AdamV3D/RR-V-Minion-Mods/2kg or Larger Spool Holder/2KG or larger spool holder 100mm wide spool.png

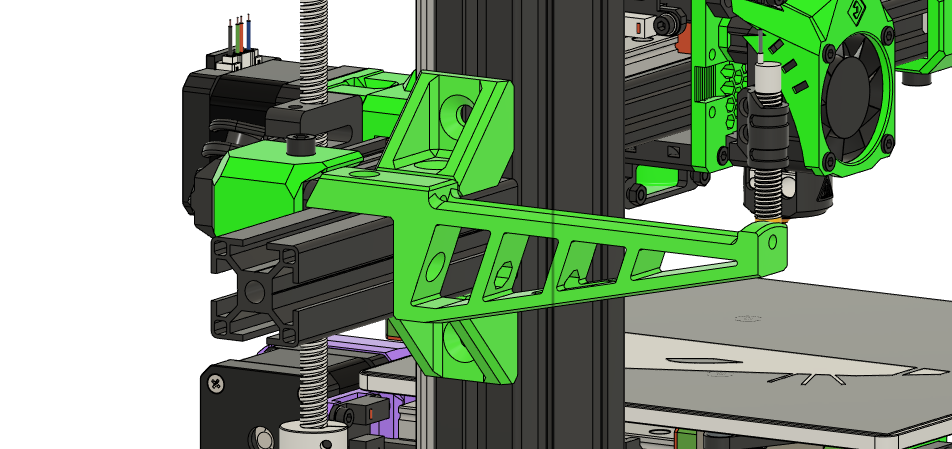
2kg or Larger Spool Holder/2KG or larger spool holder 100mm wide spool.png
