AdamV3D/RR-V-Minion-Mods/2kg or Larger Spool Holder/Large Spool Holder (2).jpg

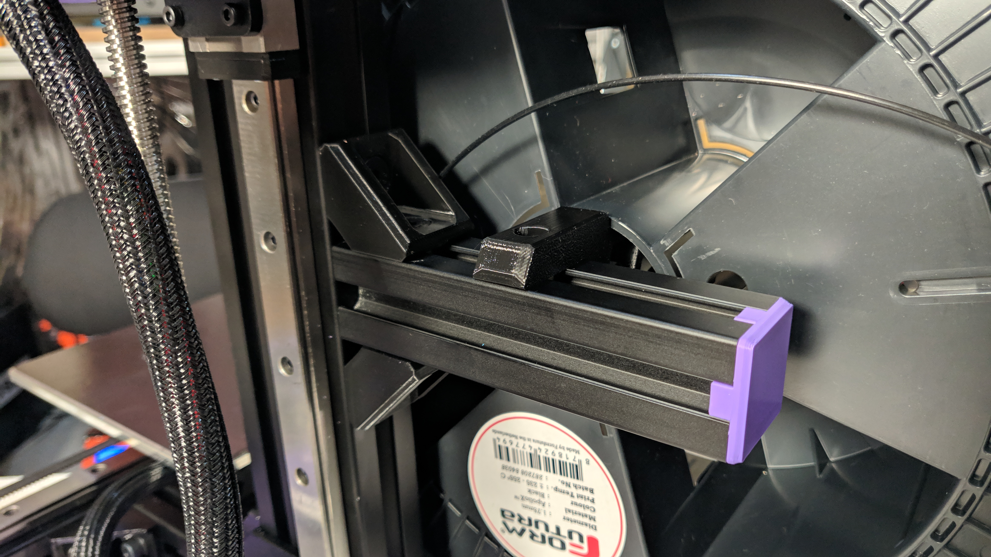
2kg or Larger Spool Holder/Large Spool Holder (2).jpg
