AdamV3D/RR-V-Minion-Mods/Single Piece Spool Holder/spool holder alone.png

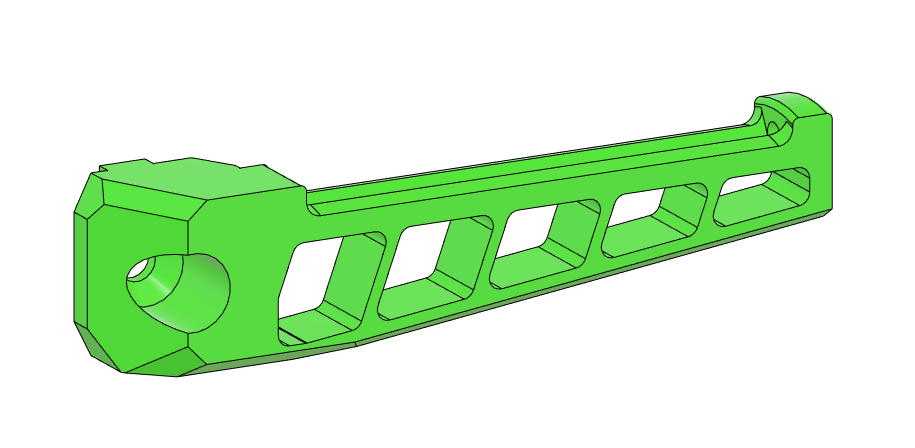
Single Piece Spool Holder/spool holder alone.png
