AdamV3D/RR-V-Minion-Mods/Single Piece Spool Holder/Spool Holder Mounted.png

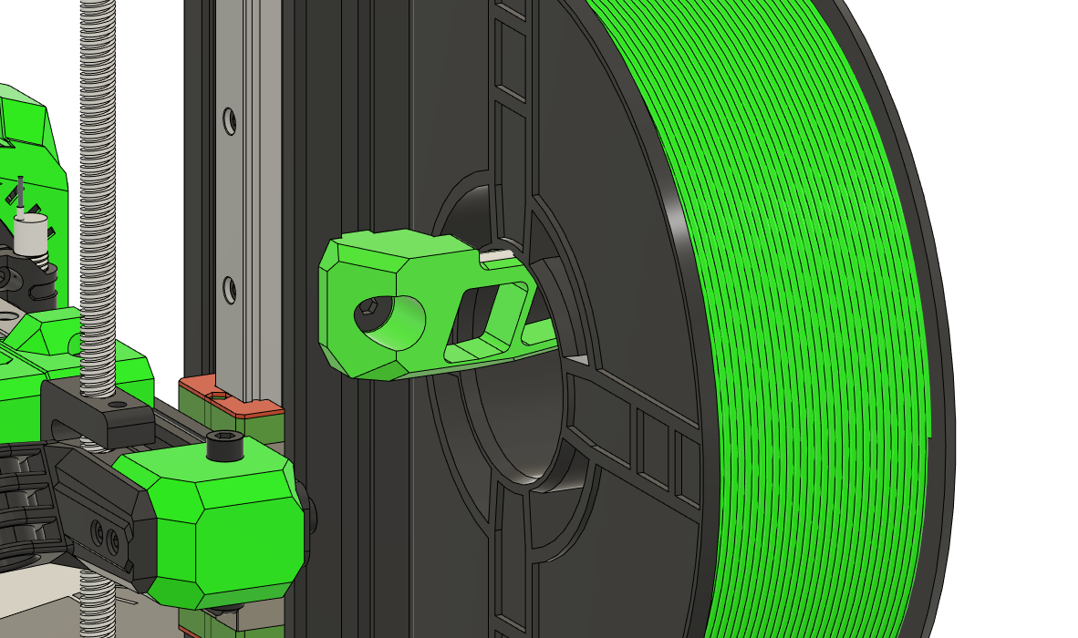
Single Piece Spool Holder/Spool Holder Mounted.png
