AdamV3D/RR-V-Minion-Mods/Single Piece Spool Holder/spool holder with PTFE tube.png

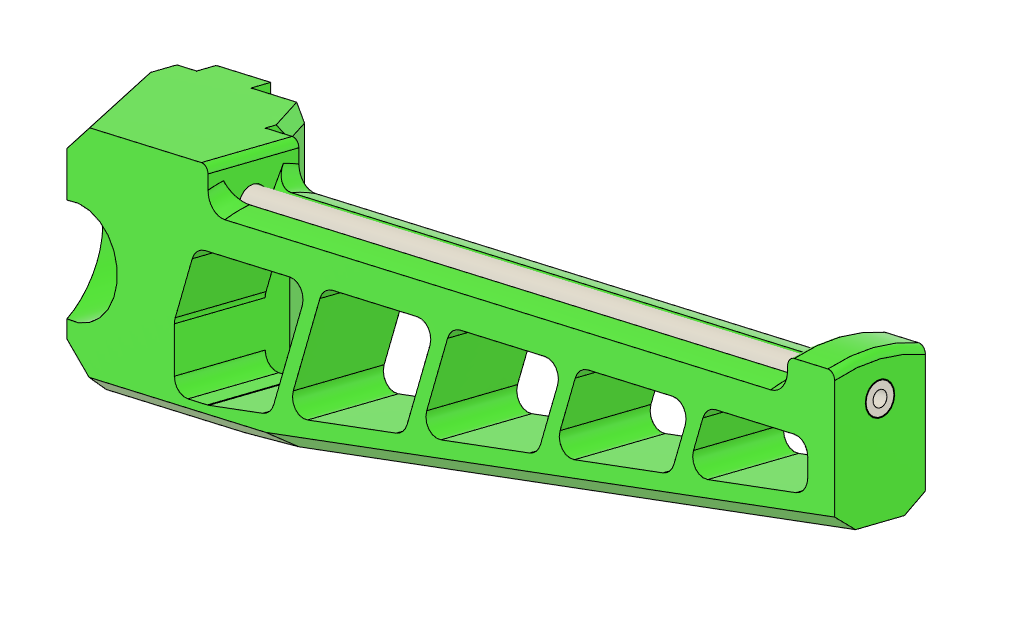
Single Piece Spool Holder/spool holder with PTFE tube.png
