AdamV3D/RR-V-Minion-Mods/Z Top with Stop And Feed tube/Z Cap with Feed Tube (1).jpg

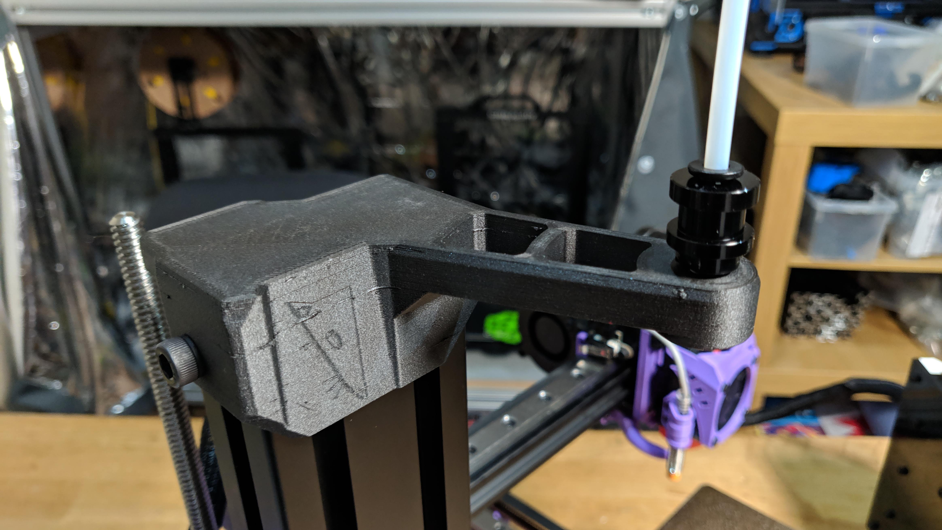
Z Top with Stop And Feed tube/Z Cap with Feed Tube (1).jpg
