AdamV3D/RR-V-Minion-Mods/Z Top with Stop And Feed tube/Z Cap with Feed Tube (3).jpg

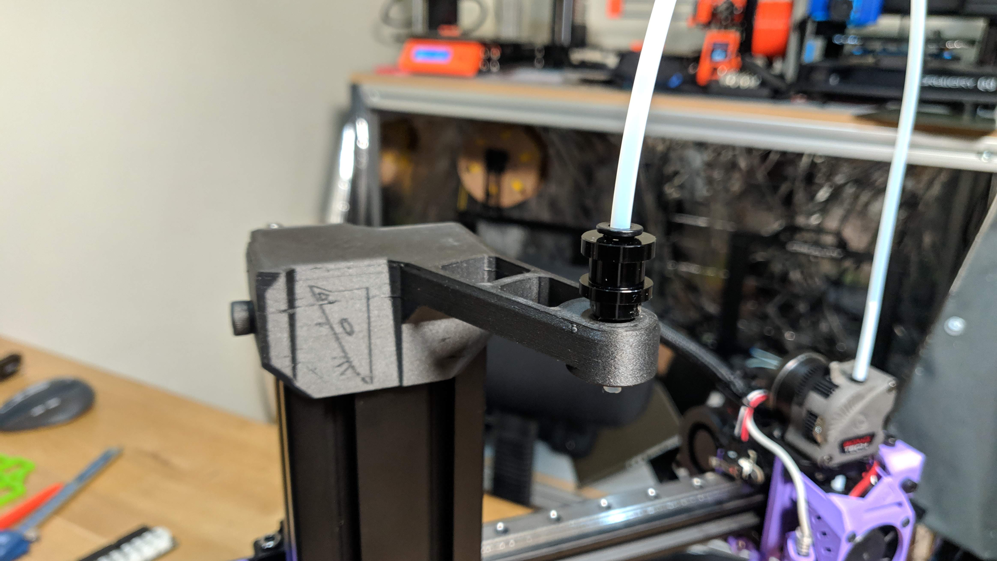
Z Top with Stop And Feed tube/Z Cap with Feed Tube (3).jpg
