AdamV3D/RR-V-Minion-Mods/2kg or Larger Spool Holder/Single Piece 2KG Spool Holder v16.stl

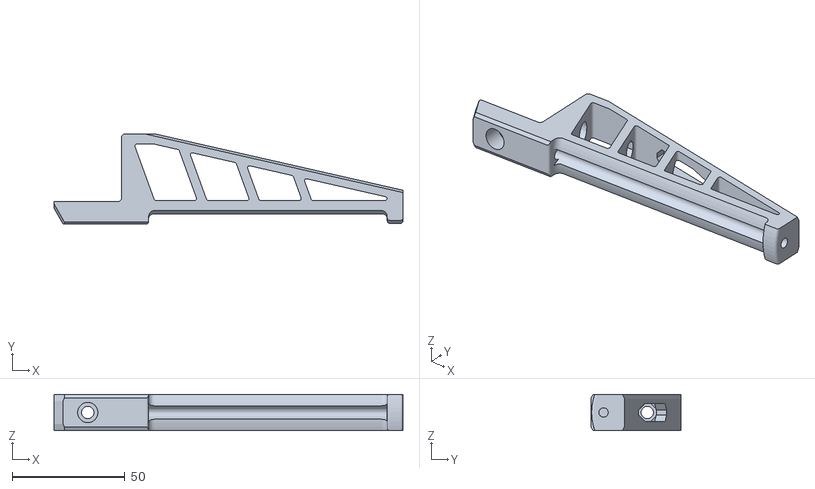
[picture p12: CAD file, 2022-04-16]
2kg or Larger Spool Holder/Single Piece 2KG Spool Holder v16.stl
155.0 x 40.0 x 16.0
