AdamV3D/RR-V-Minion-Mods/ABS Optimised and Orientated Parts/STL/x_motor_cage v8(eva3).stl

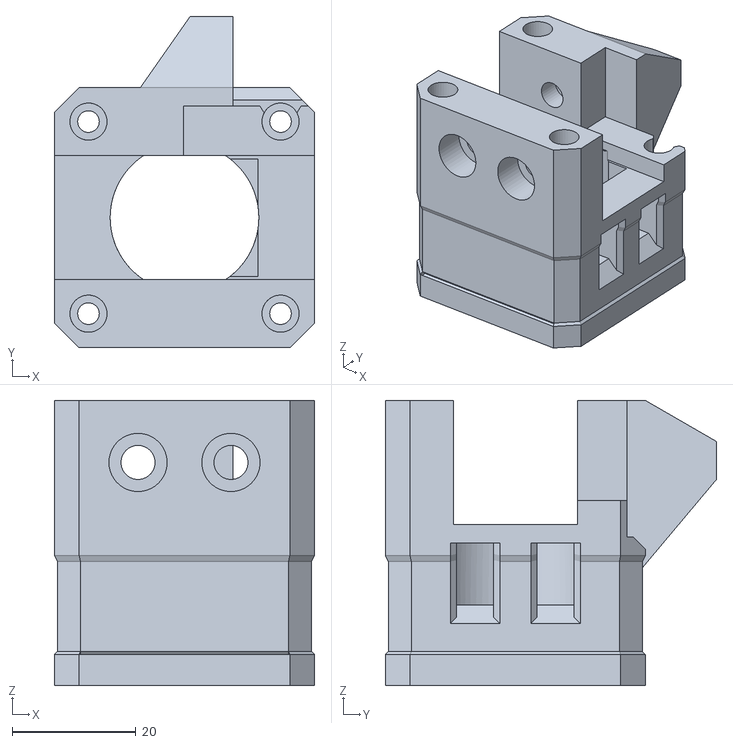
[picture p13: CAD file, 2022-08-25]
ABS Optimised and Orientated Parts/STL/x_motor_cage v8(eva3).stl
42.0 x 53.5 x 46.0
