AdamV3D/RR-V-Minion-Mods/Single Piece Spool Holder/Single Piece Spool Holder v28.stl

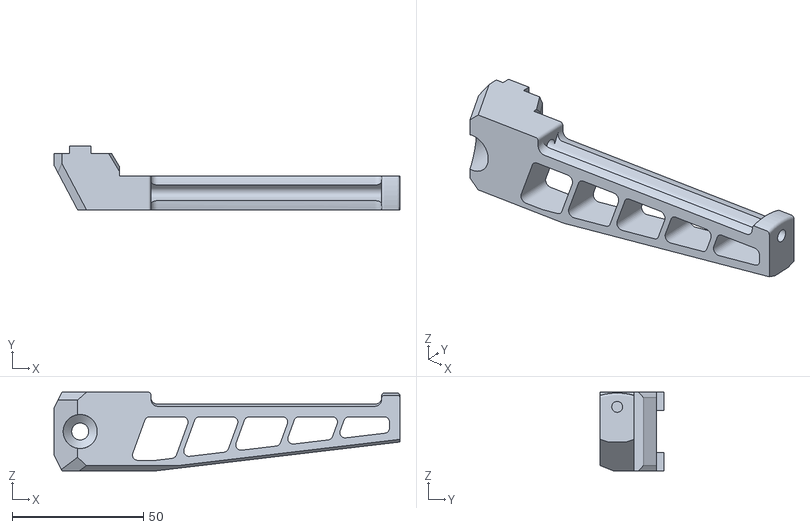
[picture p15: CAD file, 2022-05-04]
Single Piece Spool Holder/Single Piece Spool Holder v28.stl
132.0 x 24.3 x 30.0
