AdamV3D/RR-V-Minion-Mods/V3D Divider PCB/STL/PCB Enclosure v67_Lid_.stl

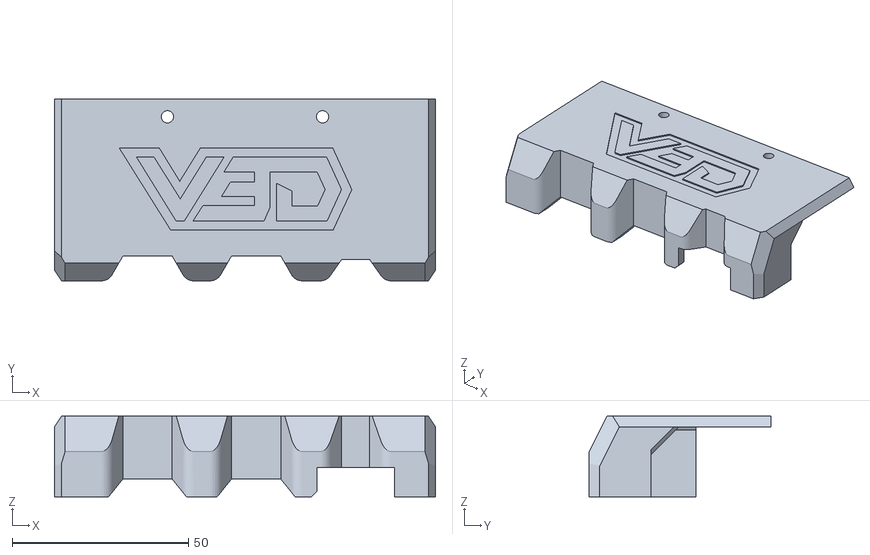
[picture p16: CAD file, 2022-07-07]
V3D Divider PCB/STL/PCB Enclosure v67_Lid_.stl
108.0 x 51.5 x 22.9
