AdamV3D/RR-V-Minion-Mods/Z Top with Stop And Feed tube/z_cap with feedtube v4.stl

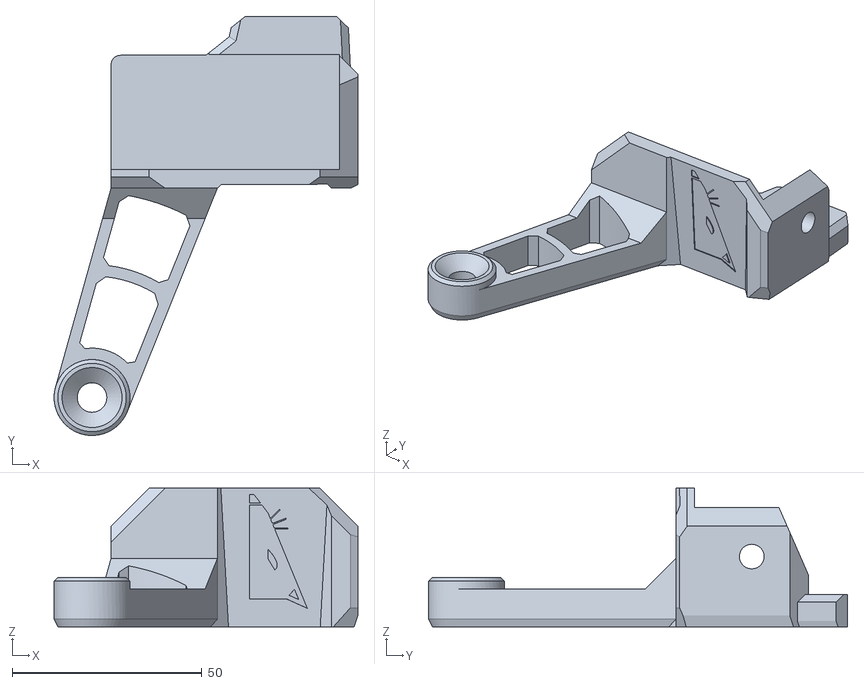
[picture p17: CAD file, 2022-05-08]
Z Top with Stop And Feed tube/z_cap with feedtube v4.stl
80.0 x 110.3 x 36.5
