AdamV3D/RR-V-Minion-Mods/2kg or Larger Spool Holder/Simple Angle Bracket v5.stl

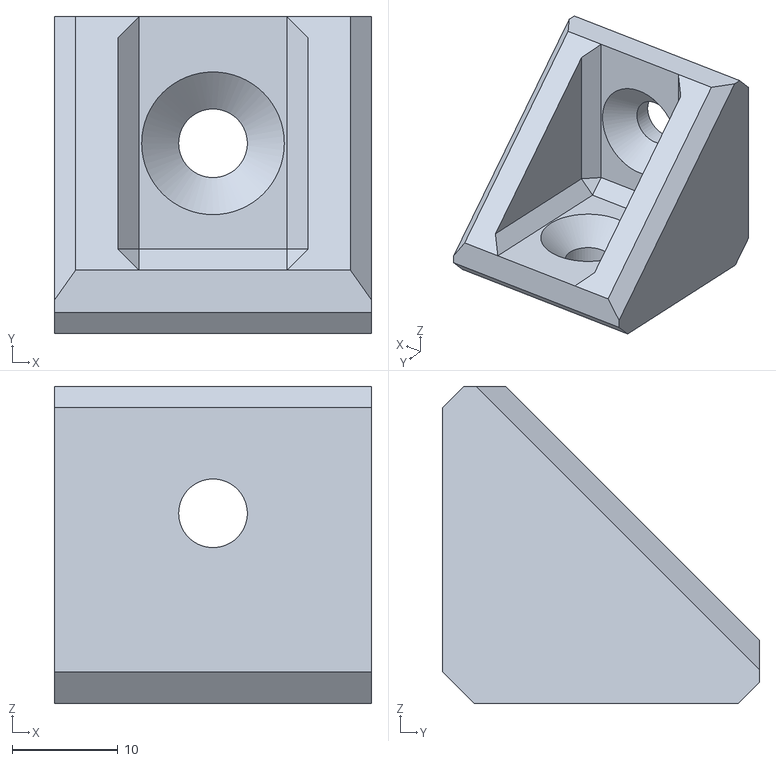
[picture p18: CAD file, 2022-04-16]
2kg or Larger Spool Holder/Simple Angle Bracket v5.stl
30.0 x 30.0 x 30.0
