AdamV3D/RR-V-Minion-Mods/ABS Optimised and Orientated Parts/STL/z_motor_cage v6.stl

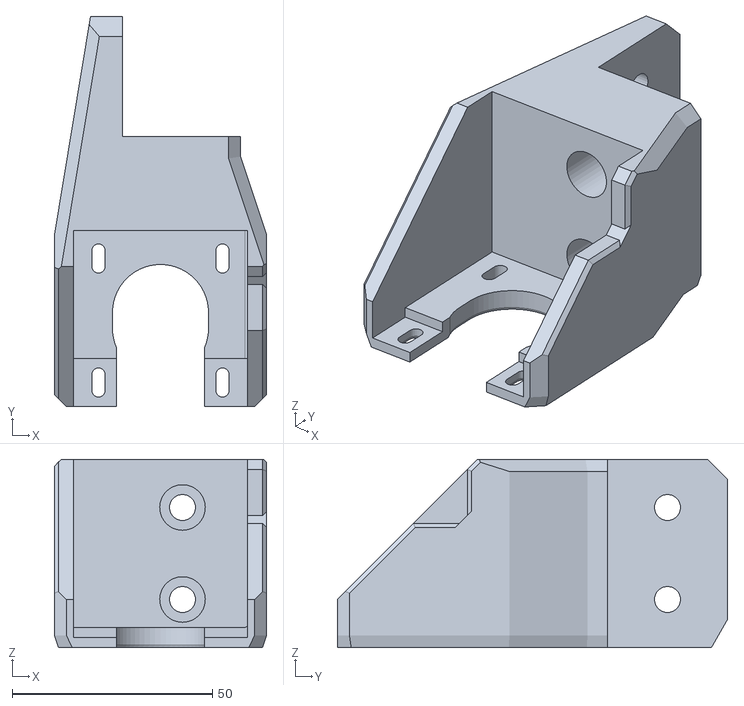
[picture p19: CAD file, 2022-04-15]
ABS Optimised and Orientated Parts/STL/z_motor_cage v6.stl
53.0 x 97.5 x 47.0
