AdamV3D/RR-V-Minion-Mods/Assembly Jigs/STL/Y Linear Rail Jig End v7.stl

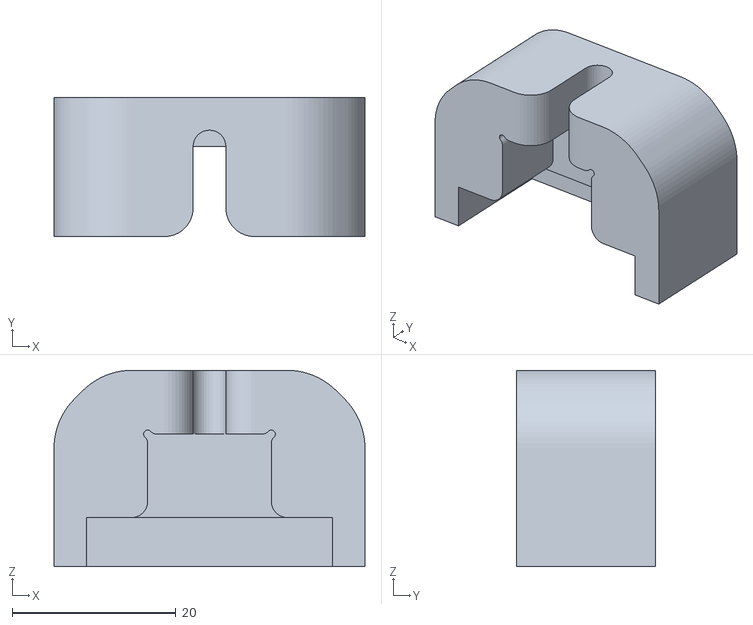
[picture p20: CAD file, 2022-03-29]
Assembly Jigs/STL/Y Linear Rail Jig End v7.stl
38.0 x 17.0 x 24.0
