AdamV3D/RR-V-Minion-Mods/V3D Divider PCB/STL/PCB Enclosure v67.step

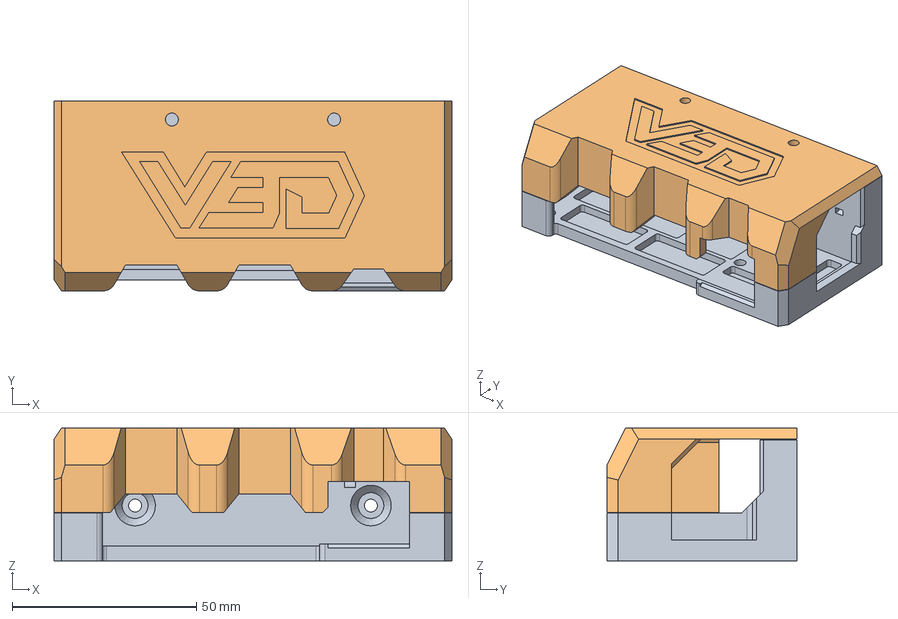
[picture p21: CAD file, 2022-07-07]
V3D Divider PCB/STL/PCB Enclosure v67.step
108.0 x 51.5 x 36.0 mm
