AdamV3D/RR-V-Minion-Mods/ABS Optimised and Orientated Parts/STL/3030 Spool Holder Mount_Extended v6.stl

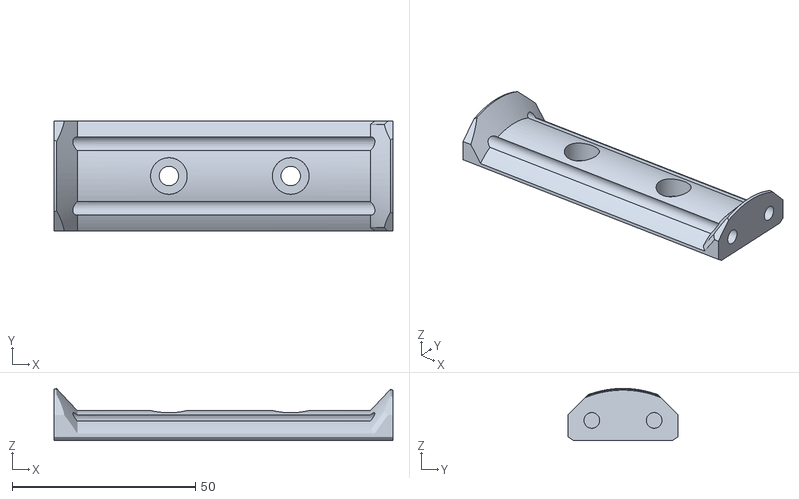
[picture p22: CAD file, 2022-04-03]
ABS Optimised and Orientated Parts/STL/3030 Spool Holder Mount_Extended v6.stl
92.5 x 30.0 x 14.2
