AdamV3D/RR-V-Minion-Mods/Assembly Jigs/STL/Z Linear Rail Jig v5.stl

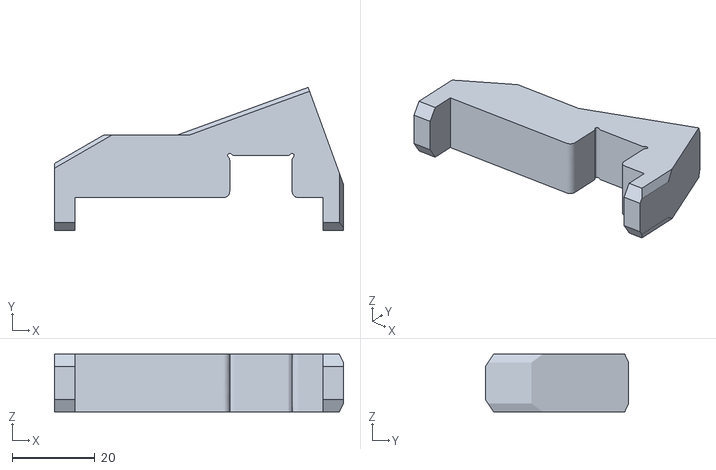
[picture p23: CAD file, 2022-03-29]
Assembly Jigs/STL/Z Linear Rail Jig v5.stl
70.0 x 34.7 x 14.0
