AdamV3D/RR-V-Minion-Mods/ABS Optimised and Orientated Parts/STL/z_cap v15.stl

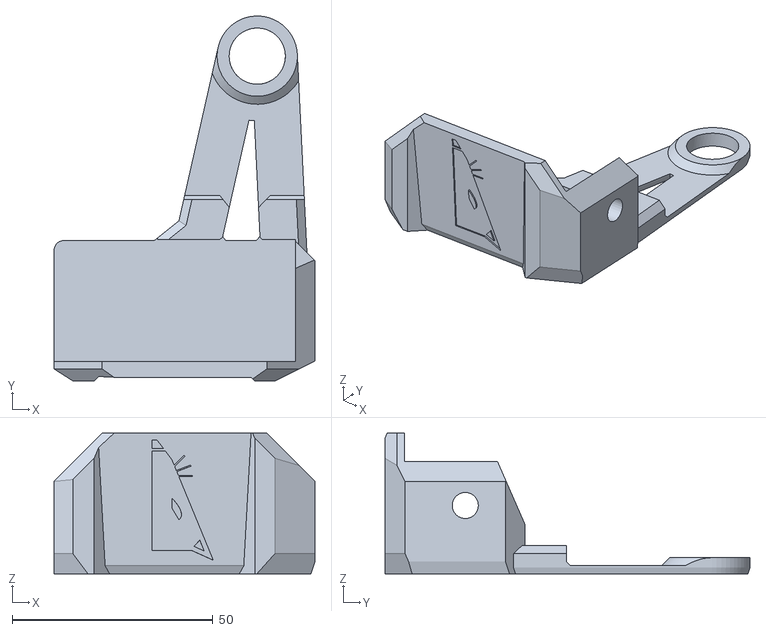
[picture p25: CAD file, 2022-03-19]
ABS Optimised and Orientated Parts/STL/z_cap v15.stl
65.0 x 90.9 x 35.0
