AdamV3D/RR-V-Minion-Mods/V3D Divider PCB/STL/Divider PCB Soldering Jig v25.stl

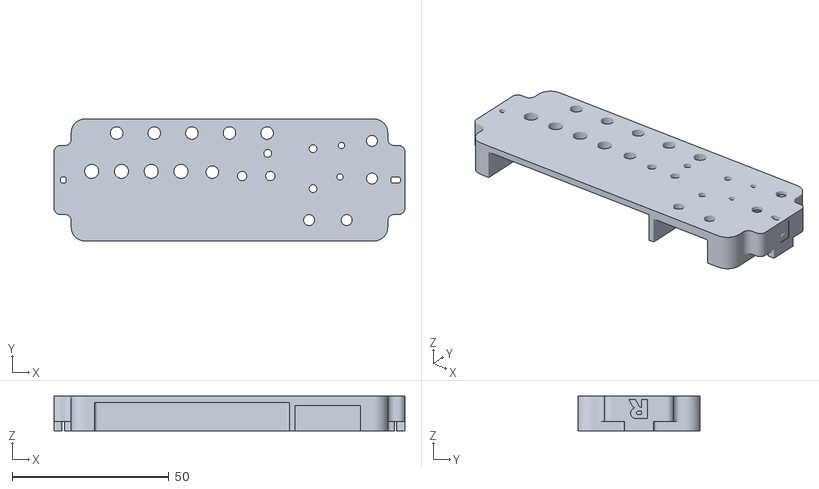
[picture p26: CAD file, 2022-04-27]
V3D Divider PCB/STL/Divider PCB Soldering Jig v25.stl
112.0 x 39.0 x 11.1
