AdamV3D/RR-V-Minion-Mods/ABS Optimised and Orientated Parts/STL/3030_end_cap v3.stl

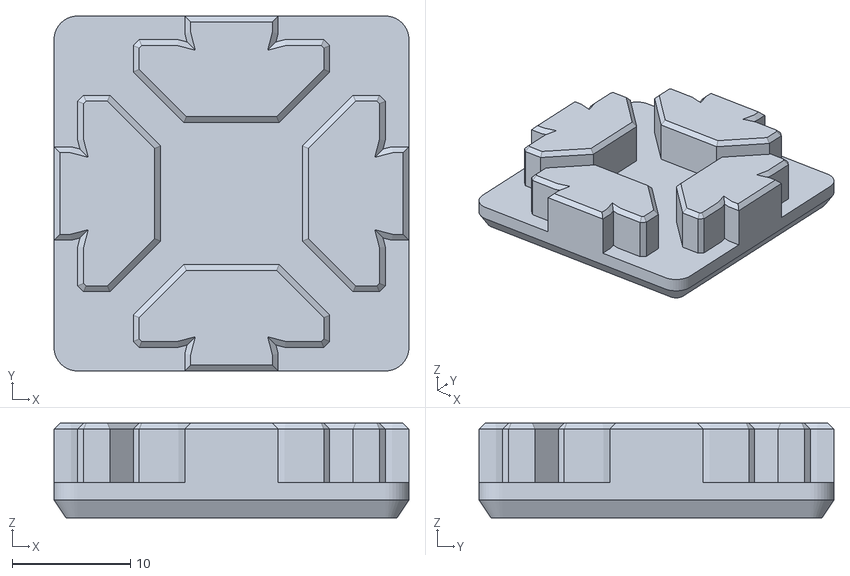
[picture p27: CAD file, 2022-03-19]
ABS Optimised and Orientated Parts/STL/3030_end_cap v3.stl
30.0 x 30.0 x 8.00
