AdamV3D/RR-V-Minion-Mods/ABS Optimised and Orientated Parts/STL/side_legs v4.stl

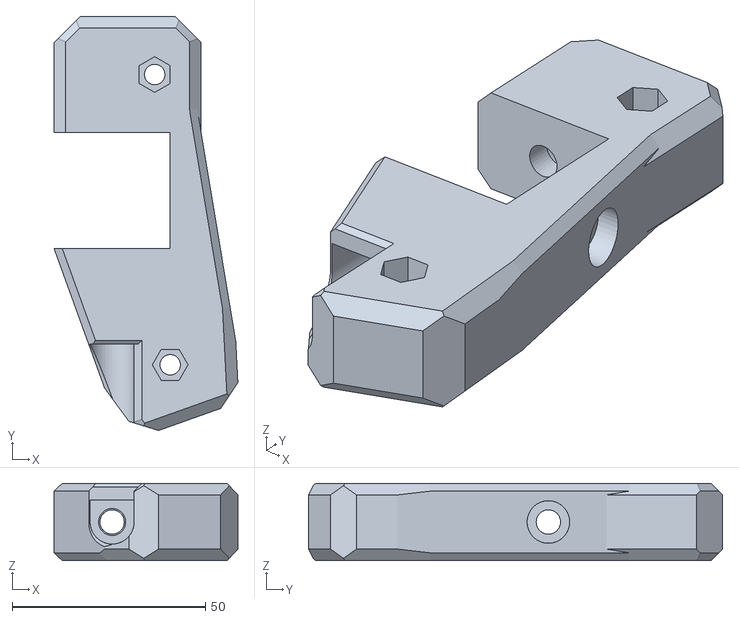
[picture p28: CAD file, 2022-03-19]
ABS Optimised and Orientated Parts/STL/side_legs v4.stl
47.5 x 107.0 x 20.0
