AdamV3D/RR-V-Minion-Mods/ABS Optimised and Orientated Parts/STL/y_belt_mount v7.stl

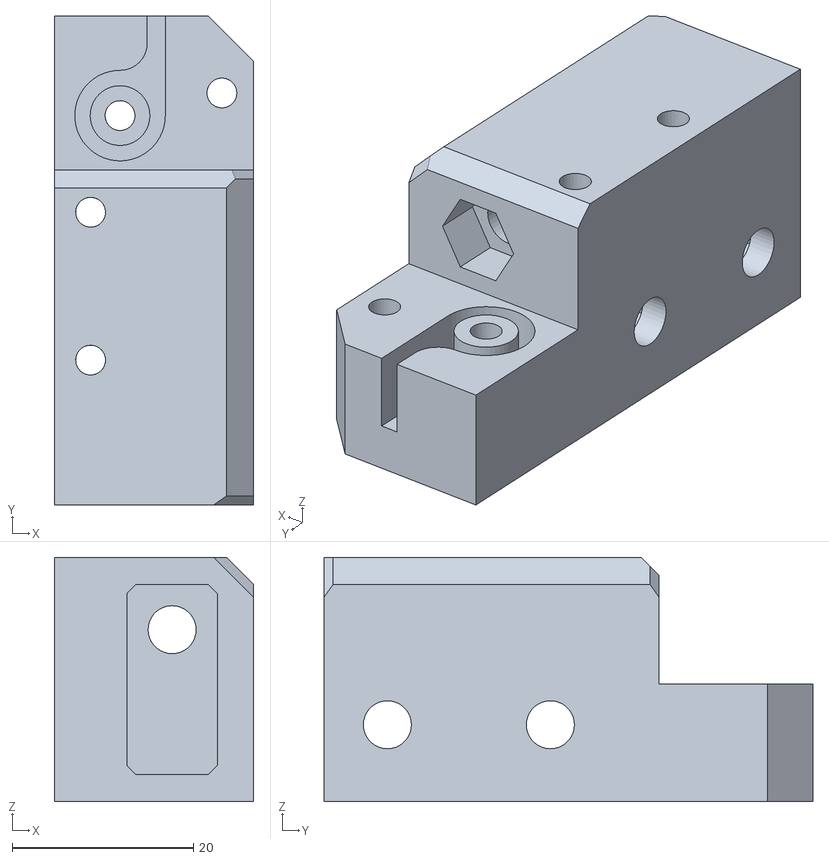
[picture p29: CAD file, 2022-03-19]
ABS Optimised and Orientated Parts/STL/y_belt_mount v7.stl
22.0 x 54.0 x 27.0
