AdamV3D/RR-V-Minion-Mods/V3D Divider PCB/STL/y_endstop_mount v18.stl

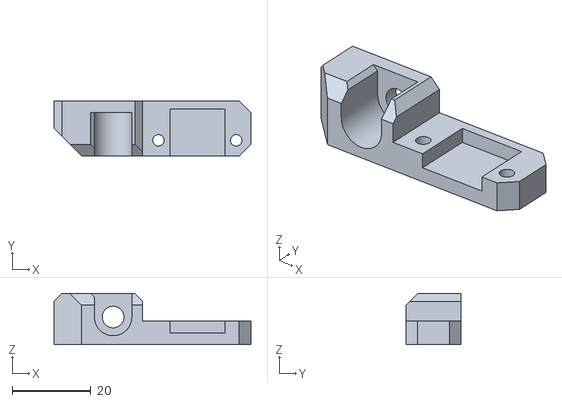
[picture p30: CAD file, 2022-03-19]
V3D Divider PCB/STL/y_endstop_mount v18.stl
50.0 x 14.0 x 13.0
