AdamV3D/RR-V-Minion-Mods/ABS Optimised and Orientated Parts/STL/bed_wire_guide_start v3.stl

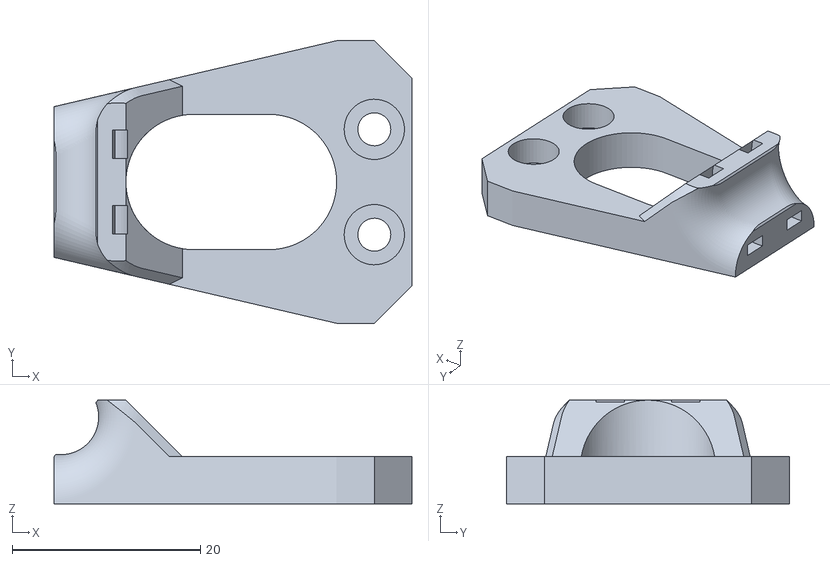
[picture p31: CAD file, 2022-03-19]
ABS Optimised and Orientated Parts/STL/bed_wire_guide_start v3.stl
38.0 x 30.0 x 11.0
