AdamV3D/RR-V-Minion-Mods/ABS Optimised and Orientated Parts/STL/x_motor_cage v5(eva2).stl

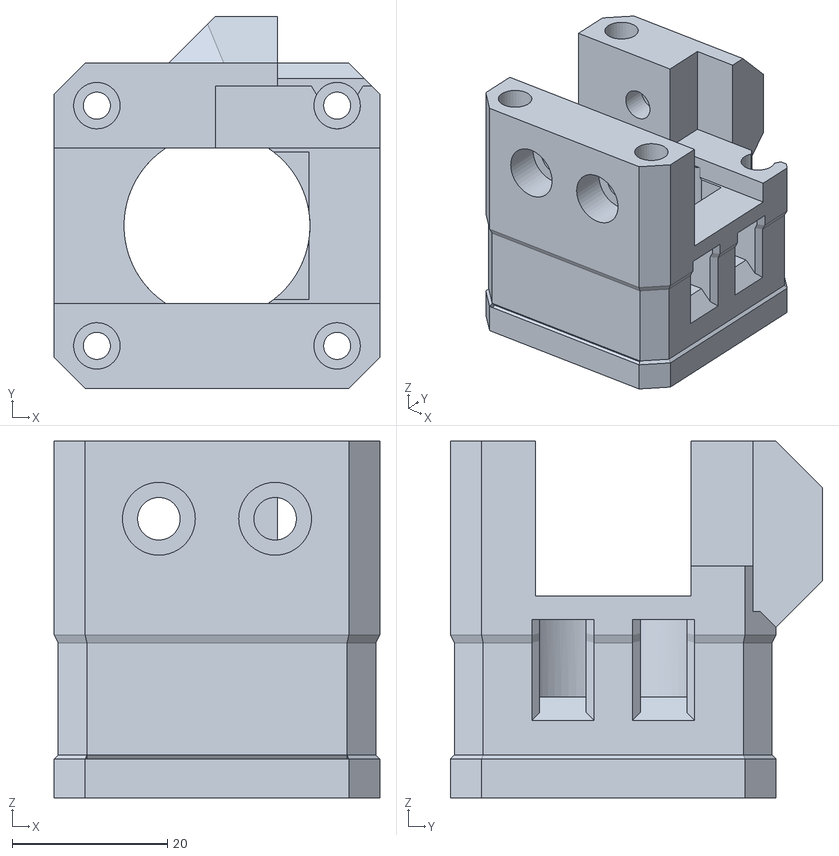
[picture p33: CAD file, 2022-03-19]
ABS Optimised and Orientated Parts/STL/x_motor_cage v5(eva2).stl
42.0 x 48.0 x 46.0
