AdamV3D/RR-V-Minion-Mods/ABS Optimised and Orientated Parts/STL/case_wire_holder v2.stl

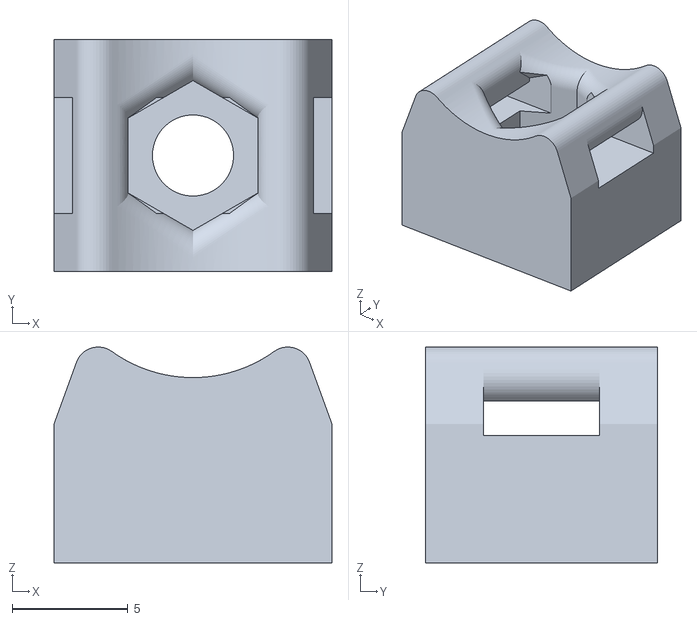
[picture p34: CAD file, 2022-03-19]
ABS Optimised and Orientated Parts/STL/case_wire_holder v2.stl
12.0 x 10.0 x 9.32
