AdamV3D/RR-V-Minion-Mods/ABS Optimised and Orientated Parts/STL/y_belt_tensioner v3.stl

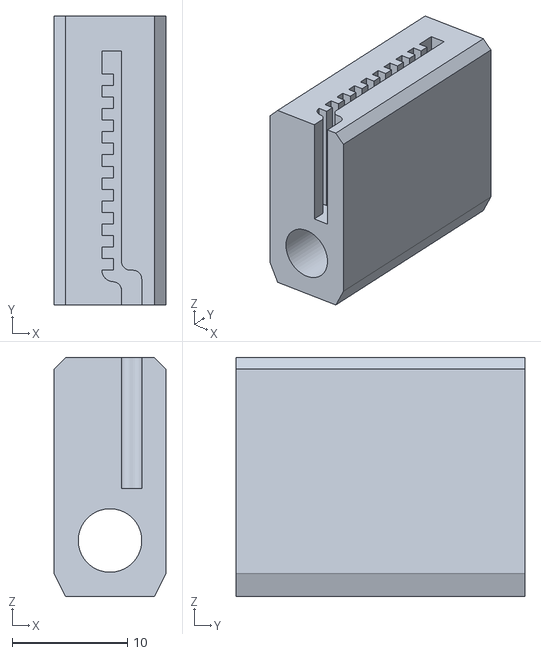
[picture p35: CAD file, 2022-03-19]
ABS Optimised and Orientated Parts/STL/y_belt_tensioner v3.stl
9.70 x 25.0 x 20.7
