AdamV3D/RR-V-Minion-Mods/ABS Optimised and Orientated Parts/STL/case_front v4.stl

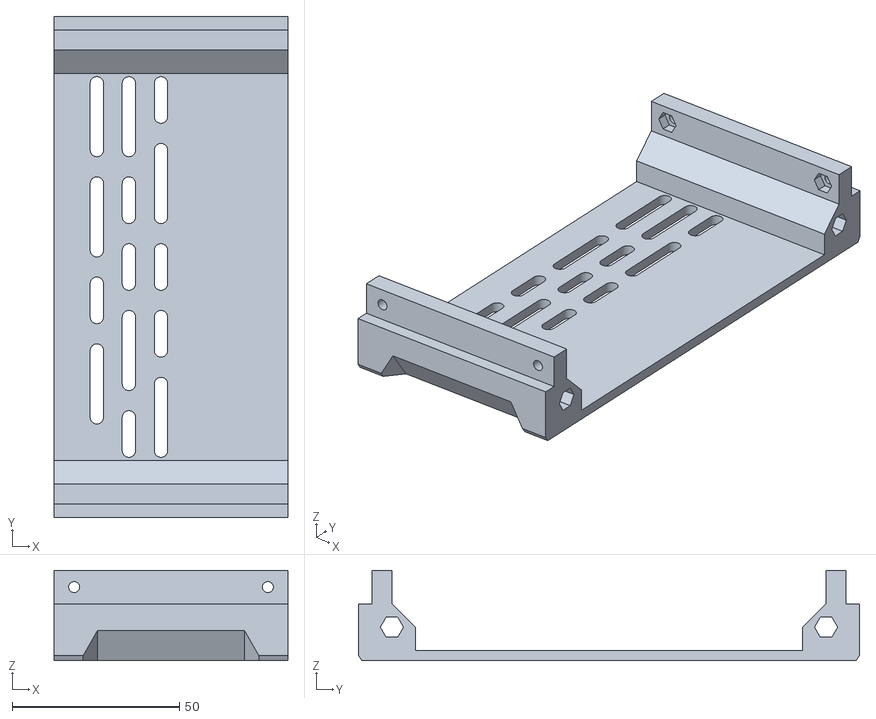
[picture p36: CAD file, 2022-03-19]
ABS Optimised and Orientated Parts/STL/case_front v4.stl
70.0 x 150.0 x 27.0
