AdamV3D/RR-V-Minion-Mods/ABS Optimised and Orientated Parts/STL/z_motor_cage_plug v2.stl

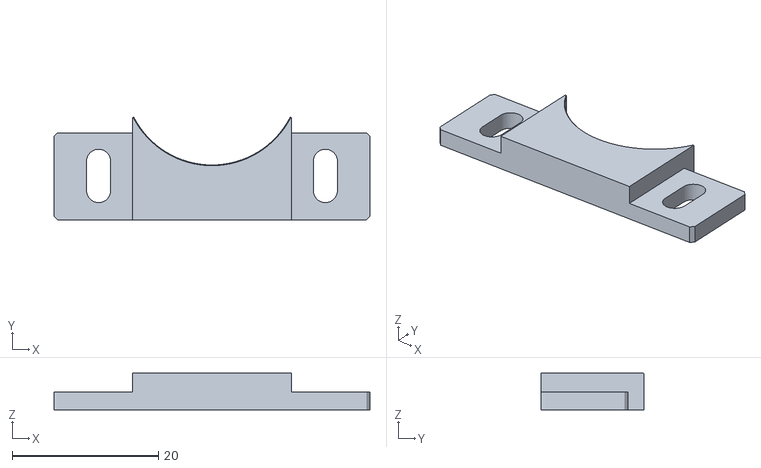
[picture p37: CAD file, 2022-03-19]
ABS Optimised and Orientated Parts/STL/z_motor_cage_plug v2.stl
43.2 x 14.0 x 5.00
