AdamV3D/RR-V-Minion-Mods/ABS Optimised and Orientated Parts/STL/bed_wire_guide_end v4.stl

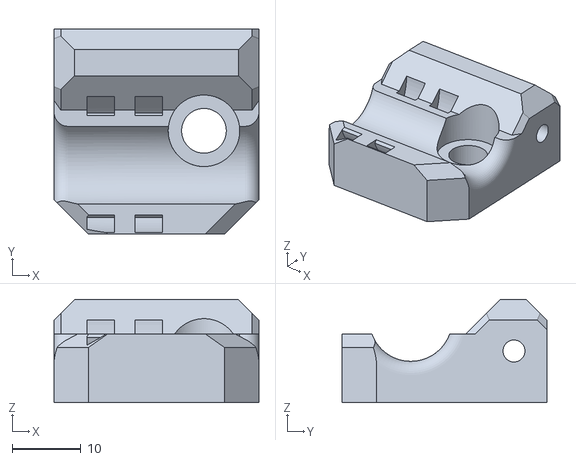
[picture p38: CAD file, 2022-03-19]
ABS Optimised and Orientated Parts/STL/bed_wire_guide_end v4.stl
29.8 x 29.8 x 15.0
