AdamV3D/RR-V-Minion-Mods/ABS Optimised and Orientated Parts/STL/x_gantry_end_cap v5.stl

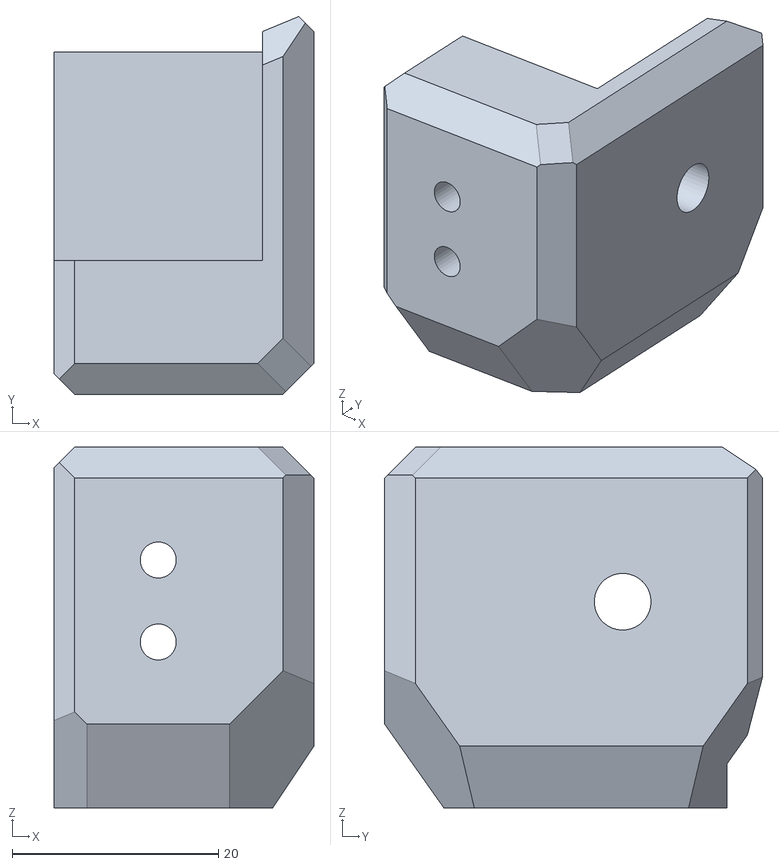
[picture p39: CAD file, 2022-03-19]
ABS Optimised and Orientated Parts/STL/x_gantry_end_cap v5.stl
25.2 x 36.7 x 35.0
