AdamV3D/RR-V-Minion-Mods/ABS Optimised and Orientated Parts/STL/tension_slider_6mm_belt_M3s v2.stl

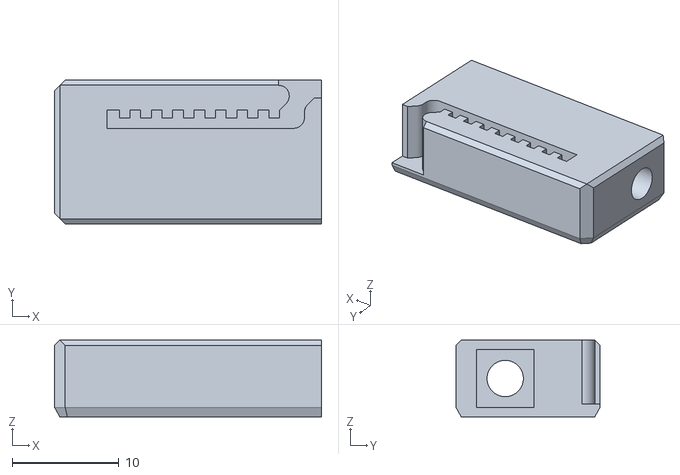
[picture p40: CAD file, 2022-03-19]
ABS Optimised and Orientated Parts/STL/tension_slider_6mm_belt_M3s v2.stl
25.0 x 13.5 x 7.20
