AdamV3D/RR-V-Minion-Mods/ABS Optimised and Orientated Parts/STL/y_idler v15.stl

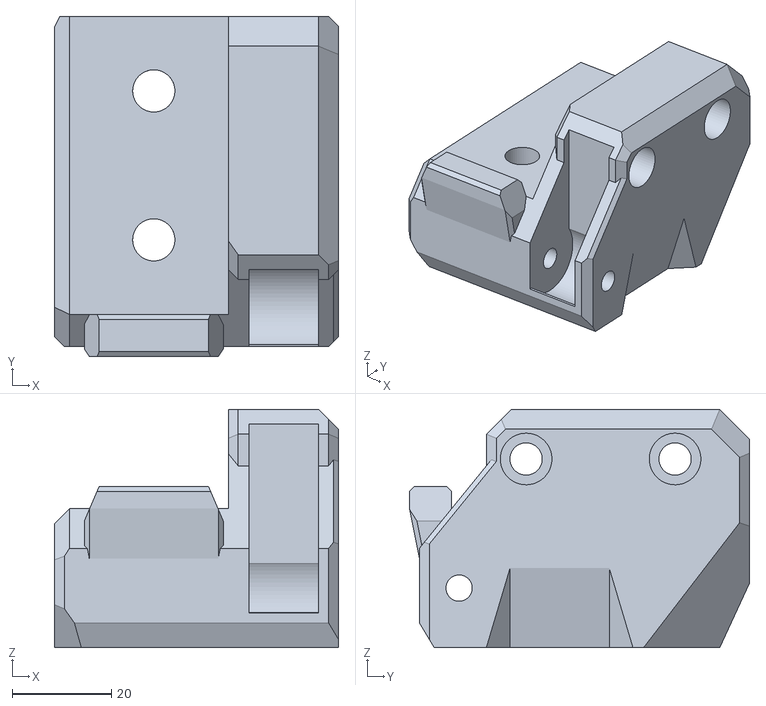
[picture p41: CAD file, 2022-03-19]
ABS Optimised and Orientated Parts/STL/y_idler v15.stl
57.2 x 68.5 x 48.0
