AdamV3D/RR-V-Minion-Mods/ABS Optimised and Orientated Parts/STL/y_motor_cage v9.stl

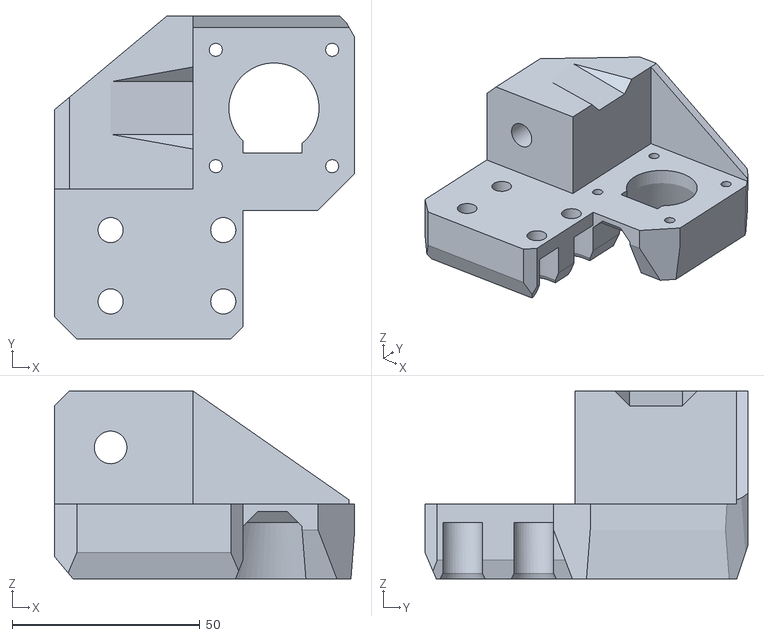
[picture p42: CAD file, 2022-03-19]
ABS Optimised and Orientated Parts/STL/y_motor_cage v9.stl
80.0 x 86.0 x 50.0
