AdamV3D/RR-V-Minion-Mods/ABS Optimised and Orientated Parts/STL/case_feet v3.stl

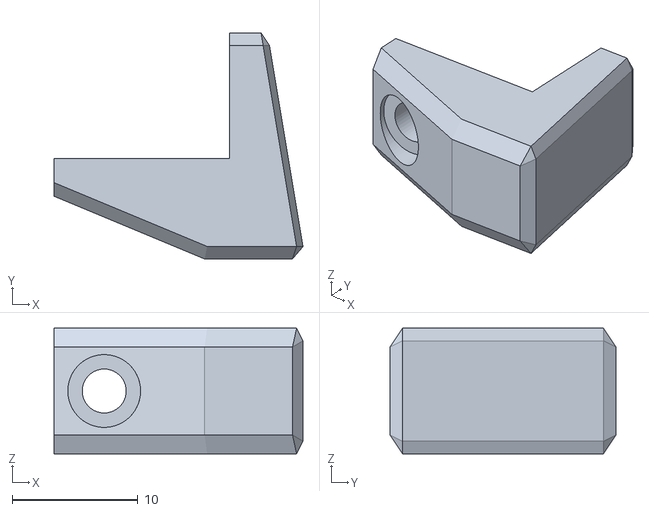
[picture p43: CAD file, 2022-03-19]
ABS Optimised and Orientated Parts/STL/case_feet v3.stl
19.8 x 18.0 x 10.0
