AdamV3D/RR-V-Minion-Mods/ABS Optimised and Orientated Parts/STL/Z Linear Rail Endstop v5.stl

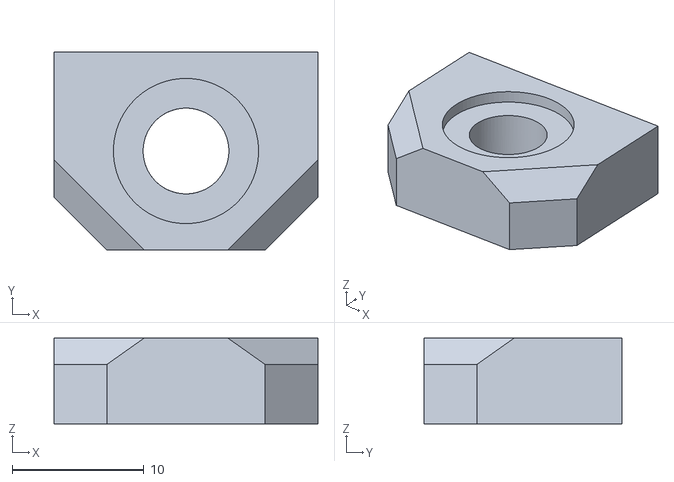
[picture p44: CAD file, 2022-03-19]
ABS Optimised and Orientated Parts/STL/Z Linear Rail Endstop v5.stl
20.0 x 15.0 x 6.50
