AdamV3D/RR-V-Minion-Mods/ABS Optimised and Orientated Parts/STL/x_idler v3.stl

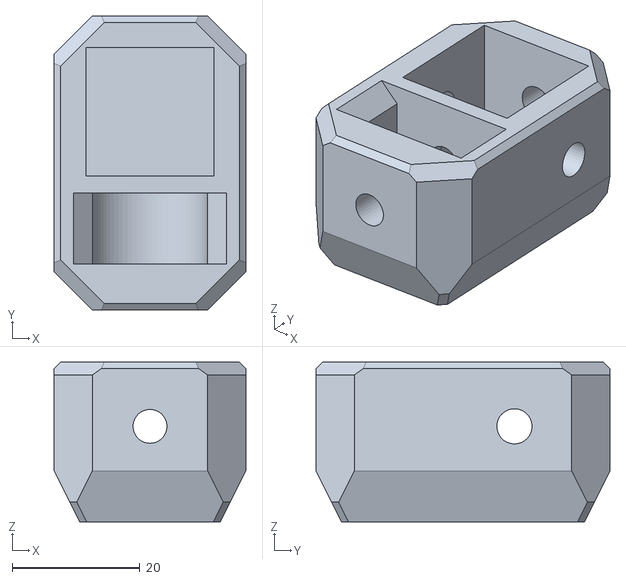
[picture p45: CAD file, 2022-03-19]
ABS Optimised and Orientated Parts/STL/x_idler v3.stl
30.0 x 46.0 x 25.0
