AdamV3D/RR-V-Minion-Mods/(list of files, cad)

Other CAD files:
2kg or Larger Spool Holder/Simple Angle Bracket v5.f3d
2kg or Larger Spool Holder/Single Piece 2KG Spool Holder v16.f3d
ABS Optimised and Orientated Parts/F3D/3030 Spool Holder Mount_Extended v6.f3d
ABS Optimised and Orientated Parts/F3D/3030_end_cap v3.f3d
ABS Optimised and Orientated Parts/F3D/Z Linear Rail Endstop v5.f3d
ABS Optimised and Orientated Parts/F3D/bed_wire_guide_end v4.f3d
ABS Optimised and Orientated Parts/F3D/bed_wire_guide_start v3.f3d
ABS Optimised and Orientated Parts/F3D/case_back v7.f3d
ABS Optimised and Orientated Parts/F3D/case_feet v3.f3d
ABS Optimised and Orientated Parts/F3D/case_front v4.f3d
ABS Optimised and Orientated Parts/F3D/case_wire_holder v2.f3d
ABS Optimised and Orientated Parts/F3D/side_legs v4.f3d
ABS Optimised and Orientated Parts/F3D/tension_slider_6mm_belt_M3s v2.f3d
ABS Optimised and Orientated Parts/F3D/x_gantry_end_cap v5.f3d
ABS Optimised and Orientated Parts/F3D/x_idler v3.f3d
ABS Optimised and Orientated Parts/F3D/x_motor_cage v5 (eva2).f3d
ABS Optimised and Orientated Parts/F3D/x_motor_cage v8 (eva3).f3d
ABS Optimised and Orientated Parts/F3D/y_belt_mount v7.f3d
ABS Optimised and Orientated Parts/F3D/y_belt_tensioner v2.f3d
ABS Optimised and Orientated Parts/F3D/y_belt_tensioner v3.f3d
ABS Optimised and Orientated Parts/F3D/y_idler v15.f3d
ABS Optimised and Orientated Parts/F3D/y_motor_cage v9.f3d
ABS Optimised and Orientated Parts/F3D/z_cap v15.f3d
ABS Optimised and Orientated Parts/F3D/z_motor_cage v4.f3d
ABS Optimised and Orientated Parts/F3D/z_motor_cage v6.f3d
ABS Optimised and Orientated Parts/F3D/z_motor_cage_plug v2.f3d
ABS Optimised and Orientated Parts/STL/y_belt_tensioner v2.stl
ABS Optimised and Orientated Parts/STL/z_motor_cage v4.stl
Assembly Jigs/F3D/Lead Screw Jig v6.f3d
Assembly Jigs/F3D/Y Linear Rail Jig End v7.f3d
Assembly Jigs/F3D/Y Linear Rail Jig v2.f3d
Assembly Jigs/F3D/Z Linear Rail Jig v5.f3d
Assembly Jigs/STL/Lead Screw Jig v6.stl
Single Piece Spool Holder/Single Piece Spool Holder v23.f3d
Single Piece Spool Holder/Single Piece Spool Holder v23.stl
Single Piece Spool Holder/Single Piece Spool Holder v27.f3d
Single Piece Spool Holder/Single Piece Spool Holder v27.stl
Single Piece Spool Holder/Single Piece Spool Holder v28.f3d
V3D Divider PCB/STL/PCB Enclosure v62_Body_.stl
V3D Divider PCB/STL/PCB Enclosure v62_Lid_.stl
Z Top with Stop And Feed tube/z_cap with feedtube v4.f3d
