AdamV3D/RR-V-Minion-Mods/(commit log)

2022-03-21 Enclosure Added
    [PCB Enclosure Body v50.stl, PCB Enclosure Lid v50.stl]
2022-03-29 Updated Jigs
    Z Rail jigs now can be used as an angled rail stand to help with assembly. Y Rails fixed to work as intended.
    [Y Linear Rail Jig End v3.f3d, Y Linear Rail Jig End v3.stl, Y Linear Rail Jig End v7.f3d, Y Linear Rail Jig End v7.stl, Y Linear Rail Jig v1.f3d, Y Linear Rail Jig v1.stl, Y Linear Rail Jig v2.f3d, Y Linear Rail Jig v2.stl]
2022-03-30 added extended spool holder for cardboard spools
    [3030 Spool Holder Mount_Extended v6.f3d]
2022-04-03 Enclosure Update
    First revision of enclosure for production released PCB
    [PCB Enclosure Body v50.stl, PCB Enclosure Body v59.stl, PCB Enclosure Lid v50.stl, PCB Enclosure Lid v59.stl]
2022-04-05 Added Assembly Instructions
    Added Assembly Instructions
2022-04-06 Assembly Manual Updated to V1.2
2022-04-08 Manual Update
    Changed then name of 'assembly instructions' to 'Divider PCB Instructions' as there is much more information than just basic assembly. Also updated lots of the contents of this file to correct errors and improve quality.
2022-04-10 Single Piece Spool Holder First Version
    [Single Piece Spool Holder v16.f3d, Single Piece Spool Holder v17.stl]
2022-04-10 Rotated into print orientation
    [Single Piece Spool Holder v17.stl, Single Piece Spool Holder v18.stl]
2022-04-11 Updated width of anti-rotation geometry
    The design has now been tested and finalised. The width of the parts which prevent rotation by holding in the extrusion slow have been made wider to prevent any wiggle.
    [Single Piece Spool Holder v16.f3d, Single Piece Spool Holder v18.stl, Single Piece Spool Holder v23.f3d, Single Piece Spool Holder v23.stl]
2022-04-15 2kg Spool Holder Parts Added
    [Simple Angle Bracket v4.f3d, Simple Angle Bracket v4.stl, Single Piece 2KG Spool Holder v11.f3d, Single Piece 2KG Spool Holder v11.stl]
2022-04-15 extended to hold 100mm wide spool
    [Single Piece 2KG Spool Holder v11.f3d, Single Piece 2KG Spool Holder v11.stl, Single Piece 2KG Spool Holder v13.f3d, Single Piece 2KG Spool Holder v13.stl]
2022-04-15 Extended to help spool avoid frame screw
    [Single Piece Spool Holder v27.f3d, Single Piece Spool Holder v27.stl]
2022-04-15 image added for show how to assemble
2022-04-15 Added Z Motor Cage
    This modified Z motor cage allows the Z motor to be rotated 90 degrees for tidier cable management, particularly with the Divider PCB mod.
    [z_motor_cage v6.f3d, z_motor_cage v6.stl]
2022-04-15 Lid Hole Size Increased
    The holes in the base for the lid were sizes for self-tapping with machines screws, but also included nut pockets. The hole size has been increased to be an M3 through hole.
    [PCB Enclosure Body v59.stl, PCB Enclosure v62_Body_.stl, PCB Enclosure v62_Lid_.stl]
2022-04-16 Minor geometry updates to improve printing
    [Simple Angle Bracket v4.f3d, Simple Angle Bracket v4.stl, Simple Angle Bracket v5.f3d, Simple Angle Bracket v5.stl, Single Piece 2KG Spool Holder v13.f3d, Single Piece 2KG Spool Holder v13.stl, Single Piece 2KG Spool Holder v16.f3d, Single Piece 2KG Spool Holder v16.stl]
2022-04-27 modified Z Motor Cage
    [z_motor_cage v6.f3d]
2022-04-27 Soldering Jig Added
    [Divider PCB Soldering Jig v25.stl]
2022-05-04 Nut Gap Extended
    The gap is increased from 15mm to 16mm to allow for slide-in T-nuts
    [Single Piece Spool Holder v28.f3d, Single Piece Spool Holder v28.stl]
2022-05-08 Z Top with stop and feed tube added
    [z_cap with feedtube v4.f3d, z_cap with feedtube v4.stl]
2022-05-27 Hotend Fan Wiring Correction on PCB Pinout Diagram
2022-05-27 Update Of Instructions
    Changed recommendation for shared GND. Previously it was recommended to connect to power supply, but since the current is low, connecting to the X-min or Y-min endstop is fine and generally easier. There has also been a reported issue when wiring to the powersupply (endstops all stayed triggered), while this may be an isolated incident, there was no reason not to change it.
2022-07-07 Enclosure v67 + STEP file
    [PCB Enclosure v67.step, PCB Enclosure v67_Body_.stl, PCB Enclosure v67_Lid_.stl]
2022-08-25 Updated Motor Cage for EVA3 Endstop Posn.
    Updated Motor Cage for EVA3 Endstop Posn.
    [x_motor_cage v5 (eva2).f3d, x_motor_cage v5(eva2).stl, x_motor_cage v8 (eva3).f3d, x_motor_cage v8(eva3).stl]
2022-09-07 Assembly Manual V1.6 Added
    Fixed an error on the wiring diagram that implied endstops, probe and servo all got their voltage from pin1 of the MF3 connector. Their respective voltage inputs pins are now correctly displayed.
